lruizleonardo1/FPGA-SPWM-Sine-Wave-Inverter/fpga/src/SineLut.vhd

library IEEE;
use IEEE.STD_LOGIC_1164.ALL;
use IEEE.STD_LOGIC_ARITH.ALL;
use IEEE.STD_LOGIC_UNSIGNED.ALL;

entity SineLut is
    Port ( 
	ANG : in STD_LOGIC_VECTOR(6 downto 0);
    SIN : out STD_LOGIC_VECTOR(12 downto 0));
end SineLut;

architecture DataFlow of SineLut is
begin
      With ANG Select SIN <=
	        "0000000000000" when "0000000",
			"0000010010011" when "0000001",
			"0000100100110" when "0000010",
			"0000110111000" when "0000011",
			"0001001001001" when "0000100",
			"0001011011000" when "0000101",
			"0001101100110" when "0000110",
			"0001111110010" when "0000111",
			"0010001111100" when "0001000",
			"0010100000010" when "0001001",
			"0010110000110" when "0001010",
			"0011000000110" when "0001011",
			"0011010000010" when "0001100",
			"0011011111011" when "0001101",
			"0011101101111" when "0001110",
			"0011111011110" when "0001111",
			"0100001001001" when "0010000",
			"0100010101110" when "0010001",
			"0100100001111" when "0010010",
			"0100101101001" when "0010011",
			"0100110111110" when "0010100",
			"0101000001101" when "0010101",
			"0101001010101" when "0010110",
			"0101010010111" when "0010111",
			"0101011010011" when "0011000",
			"0101100001000" when "0011001",
			"0101100110110" when "0011010",
			"0101101011110" when "0011011",
			"0101101111110" when "0011100",
			"0101110010111" when "0011101",
			"0101110101001" when "0011110",
			"0101110110100" when "0011111",
			"0101110111000" when "0100000",
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
			"0001111110010" when "1111001",
			"0001101100110" when "1111010",
			"0001011011000" when "1111011",
			"0001001001001" when "1111100",
			"0000110111000" when "1111101",
			"0000100100110" when "1111110",
			"0000010010011" when "1111111", 
			"0000000000000" when others;
end DataFlow;
